Agilack/cowdin-2-shutter/prj-kicad/cowdin-2-shutter.kicad_pcb

## KiCad design prj-kicad/cowdin-2-shutter.kicad_pcb (2020-05-26)

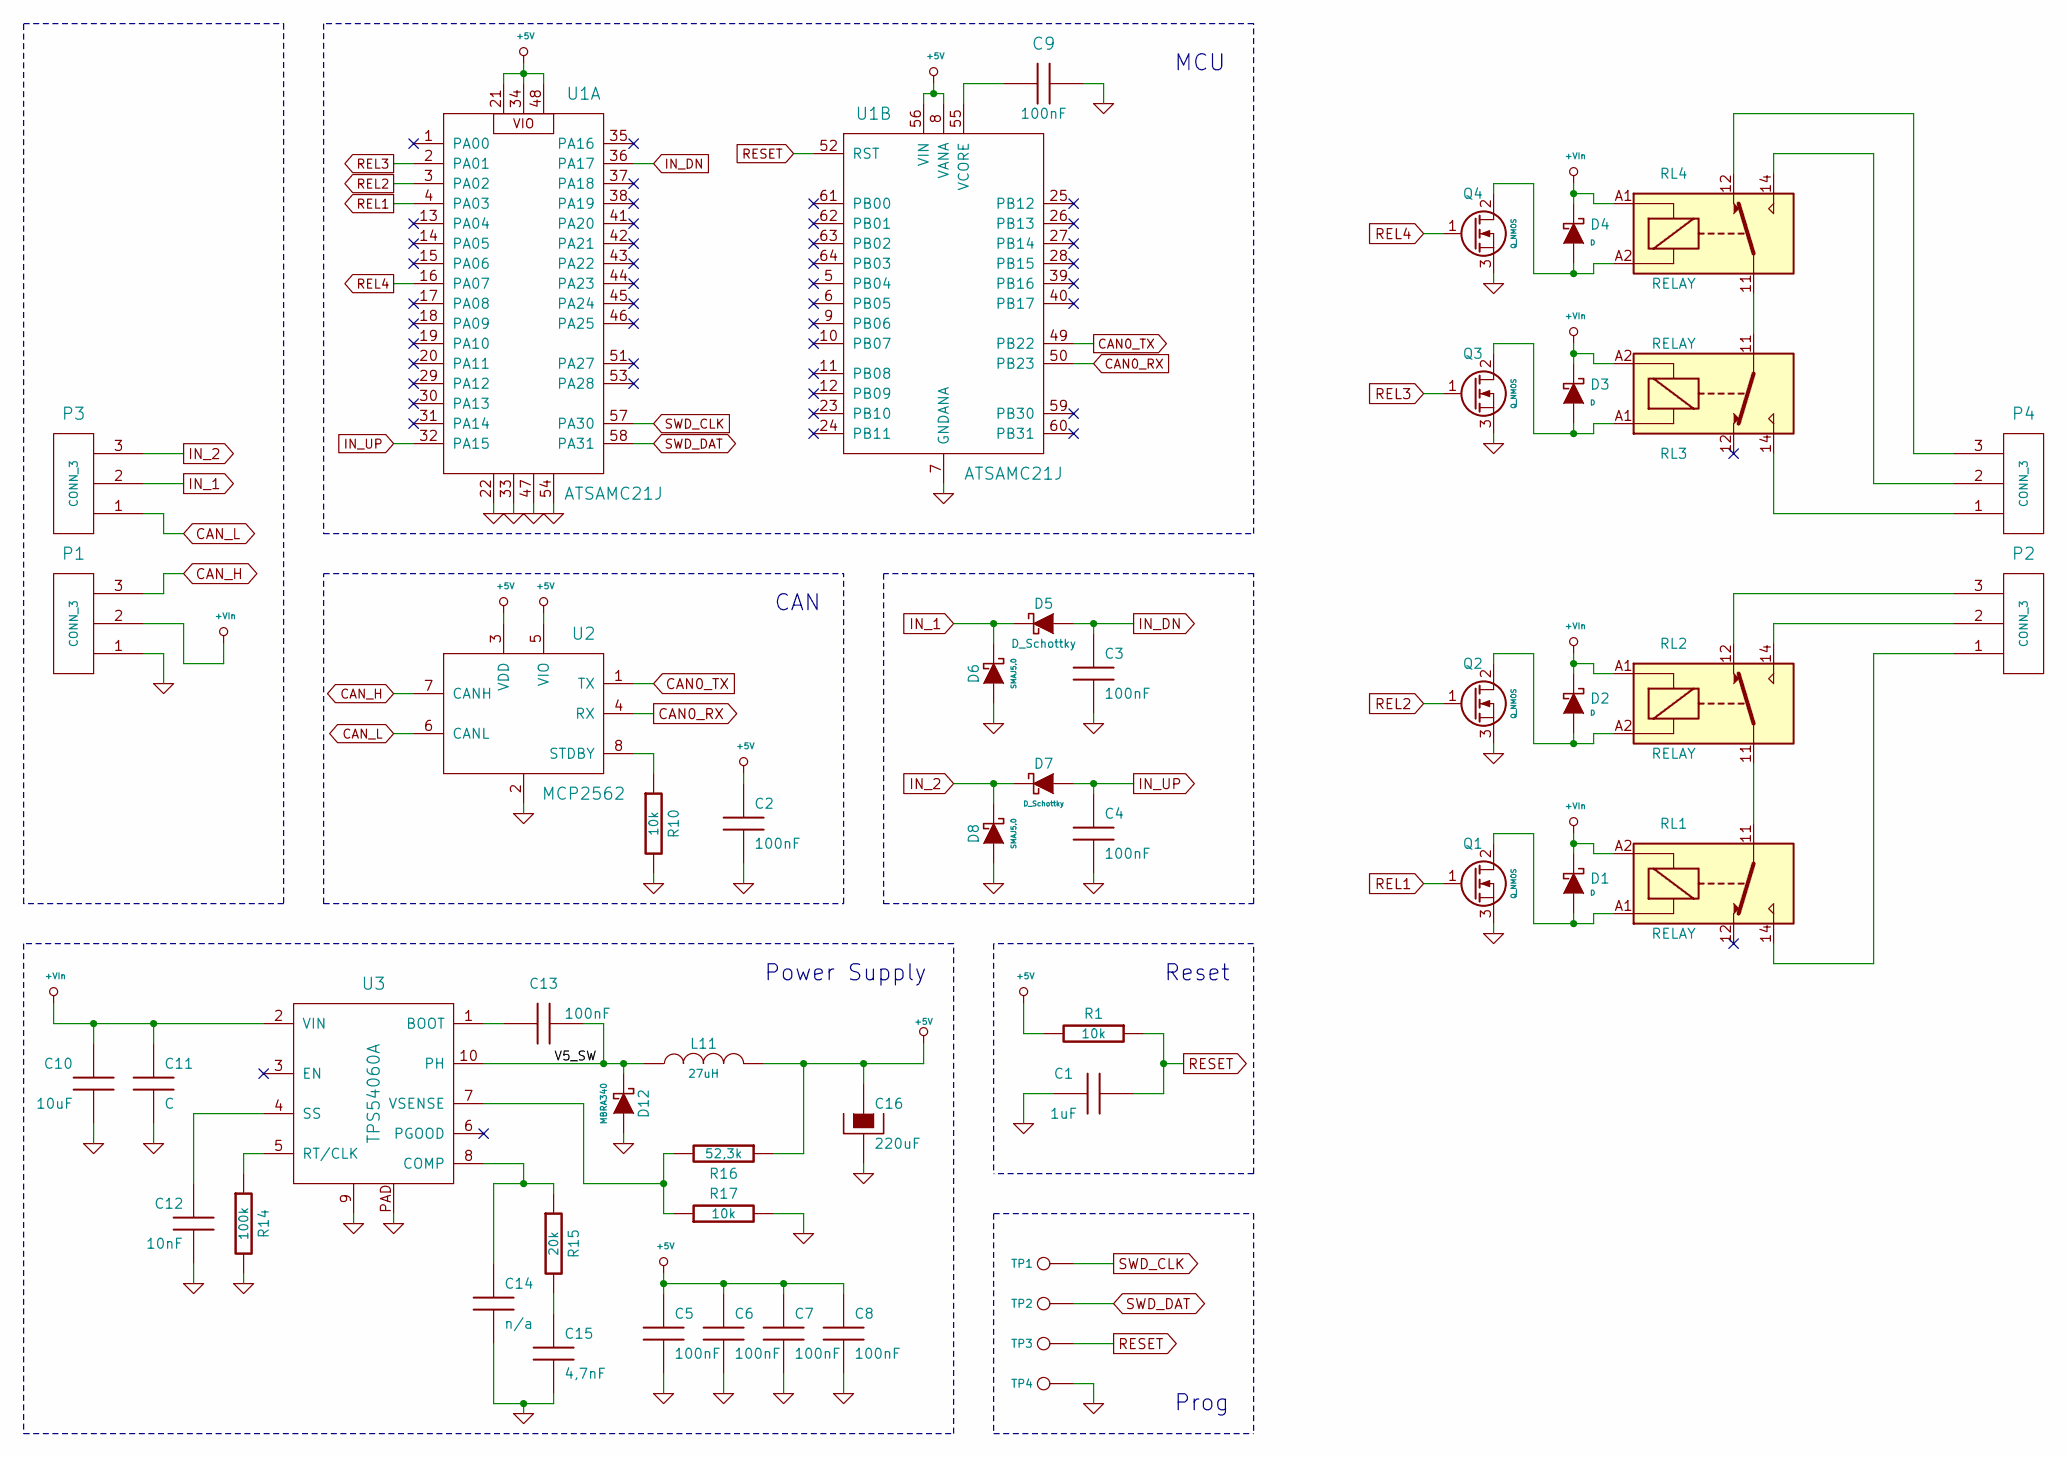
[picture p1: schematic cowdin-2-shutter.sch, CowDIN 2 Shutter]

Parts:
C1: 1uF; SMD0603
C2, C3, C4, C5, C6, C7, C8, C9, C13: 100nF; SMD0603
C10: 10uF; SMD1210
C11: C; SMD1210
C12: 10nF; SMD0603
C14: n/a; SMD0603
C15: 4,7nF; SMD0603
C16: 220uF; C_TPB_D4
D1, D2, D3, D4: D; SOD-123
D5, D7: D_Schottky; SOD-123
D6, D8: SMAJ5.0; DO214AC
D12: MBRA340; DO214AC
L11: 27uH; I_MSS1048
P1, P2, P3, P4: CONN_3; CONN_MC000035
Q1, Q2, Q3, Q4: Q_NMOS; SOT23-3
R1, R10, R17: 10k; SMD0603
R14: 100k; SMD0603
R15: 20k; SMD0603
R16: 52,3k; SMD0603
RL1, RL2, RL3, RL4: RELAY; RL_3451
TP1, TP2, TP3, TP4: CONN_1; TP_SMD
U1: ATSAMC21J; TQFP64
U2: MCP2562; SOIC-8E
U3: TPS54060A; MSOP10p

Connections:
5V: C2.1, C5.1, C6.1, C7.1, C8.1, C16.1, L11.2, R1.2, R16.1, U1.8 (VANA), U1.21, U1.34, U1.48, U1.56 (VIN), U2.3 (VDD), U2.5 (VIO)
/V5_SW: C13.2, D12.2 (K), L11.1, U3.10 (PH)
CAN0_RX: U1.50 (PB23), U2.4 (RX)
CAN0_TX: U1.49 (PB22), U2.1 (TX)
CAN_H: P1.3, U2.7 (CANH)
CAN_L: P3.1, U2.6 (CANL)
GND: C1.2, C2.2, C3.2, C4.2, C5.2, C6.2, C7.2, C8.2, C9.1, C10.2, C11.2, C12.2, C14.2, C15.2, C16.2, D6.1 (A), D8.1 (A), D12.1 (A), P1.1, Q1.3 (S), Q2.3 (S), Q3.3 (S), Q4.3 (S), R10.2, R14.2, R17.2, TP4.1, U1.7 (GNDANA), U1.22, U1.33, U1.47, U1.54, U2.2, U3.9, U3.PAD
IN_1: D5.2 (K), D6.2 (K), P3.2
IN_2: D7.2 (K), D8.2 (K), P3.3
IN_DN: C3.1, D5.1 (A), U1.36 (PA17)
IN_UP: C4.1, D7.1 (A), U1.32 (PA15)
unnamed: C9.2, U1.55 (VCORE)
unnamed: C12.1, U3.4 (SS)
unnamed: C13.1, U3.1 (BOOT)
unnamed: C14.1, R15.1, U3.8 (COMP)
unnamed: C15.1, R15.2
unnamed: D1.1 (A), Q1.2 (D), RL1.A1
unnamed: D2.1 (A), Q2.2 (D), RL2.A2
unnamed: D3.1 (A), Q3.2 (D), RL3.A1
unnamed: D4.1 (A), Q4.2 (D), RL4.A2
unnamed: P2.1, RL1.14
unnamed: P2.2, RL2.14
unnamed: P2.3, RL2.12
unnamed: P4.1, RL3.14
unnamed: P4.2, RL4.14
unnamed: P4.3, RL4.12
unnamed: R10.1, U2.8 (STDBY)
unnamed: R14.1, U3.5 (RT/CLK)
unnamed: R16.2, R17.1, U3.7 (VSENSE)
unnamed: RL1.11, RL2.11
unnamed: RL3.11, RL4.11
REL1: Q1.1 (G), U1.4 (PA03)
REL2: Q2.1 (G), U1.3 (PA02)
REL3: Q3.1 (G), U1.2 (PA01)
REL4: Q4.1 (G), U1.16 (PA07)
RESET: C1.1, R1.1, TP3.1, U1.52 (RST)
SWD_CLK: TP1.1, U1.57 (PA30)
SWD_DAT: TP2.1, U1.58 (PA31)
VIn: C10.1, C11.1, D1.2 (K), D2.2 (K), D3.2 (K), D4.2 (K), P1.2, RL1.A2, RL2.A1, RL3.A2, RL4.A1, U3.2 (VIN)

Notes on the sheet:
Power Supply
Reset
CAN
Prog
MCU

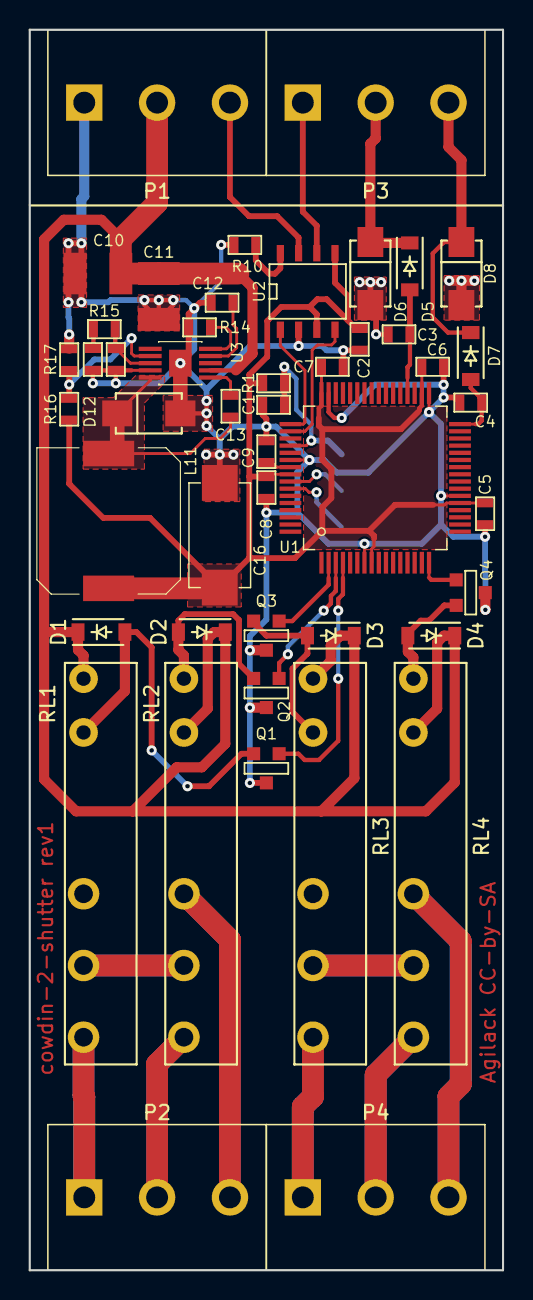
[picture p2: board cowdin-2-shutter.kicad_pcb from above]

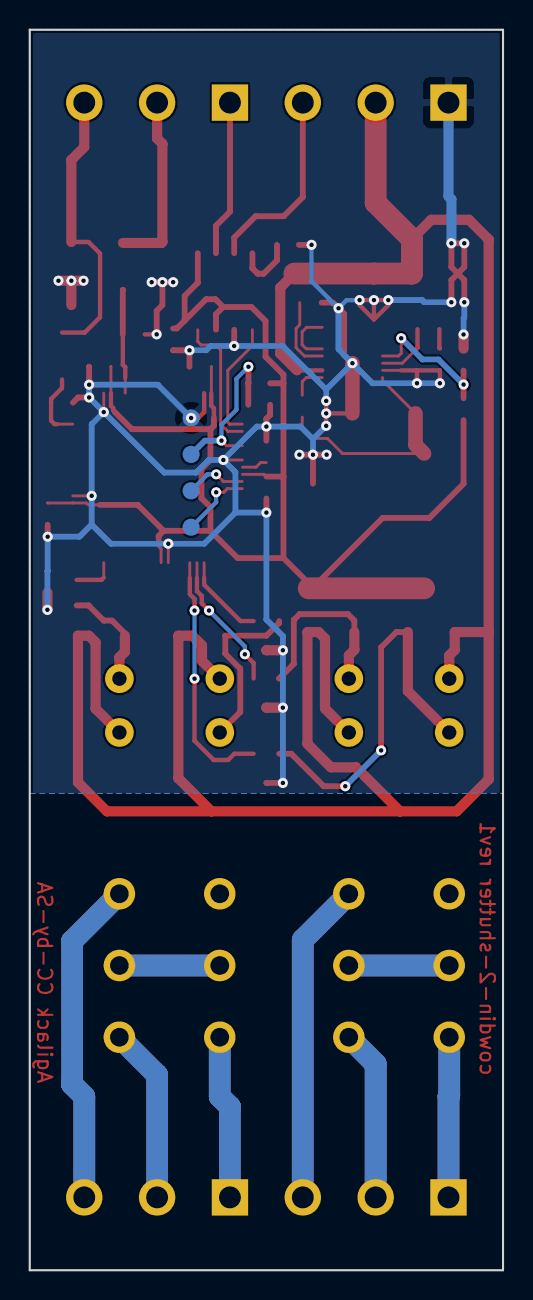
[picture p3: board cowdin-2-shutter.kicad_pcb from below]

Board: 2 copper layers, 33.0 x 86.5 mm, 51 parts (4 on the bottom side), 39 nets.
