Agilack/cowdin-2-shutter/(commit log)

2020-05-19 = ADD: Create project, add relay and connectors into schematics, create board squeleton
    [cowdin-2-shutter.kicad_pcb, cowdin-2-shutter.sch]
2020-05-20 = ADD: Insert power supply for wide VIN (5-40V) to 5V internal
    [cowdin-2-shutter.kicad_pcb, cowdin-2-shutter.sch]
2020-05-21 = ADD: Insert processor and CAN interface (sch & routing)
    [cowdin-2-shutter.kicad_pcb, cowdin-2-shutter.sch]
2020-05-22 = ADD: Insert input and output interfaces
    [cowdin-2-shutter.kicad_pcb, cowdin-2-shutter.sch]
2020-05-26 = ADD: Create production files
    [cowdin-2-shutter-B.Cu.gbl, cowdin-2-shutter-B.Mask.gbs, cowdin-2-shutter-B.Paste.gbp, cowdin-2-shutter-Edge.Cuts.gm1, cowdin-2-shutter-F.Cu.gtl, cowdin-2-shutter-F.Mask.gts, cowdin-2-shutter-F.Paste.gtp, cowdin-2-shutter-F.SilkS.gto]
2020-06-13 Firmware: Refactor and clenaup, insert FSM, create modules for ios
