Agilack/cowdin-2-shutter/(notices)

Notices in the files:
prj-kicad/cowdin-2-shutter.sch:
CC-by-SA
prj-kicad/cowdin-2-shutter.kicad_pcb:
Agilack CC-by-SA
